Summanuss/openairqmonitor/docs/images/pcb_front_2.0.png

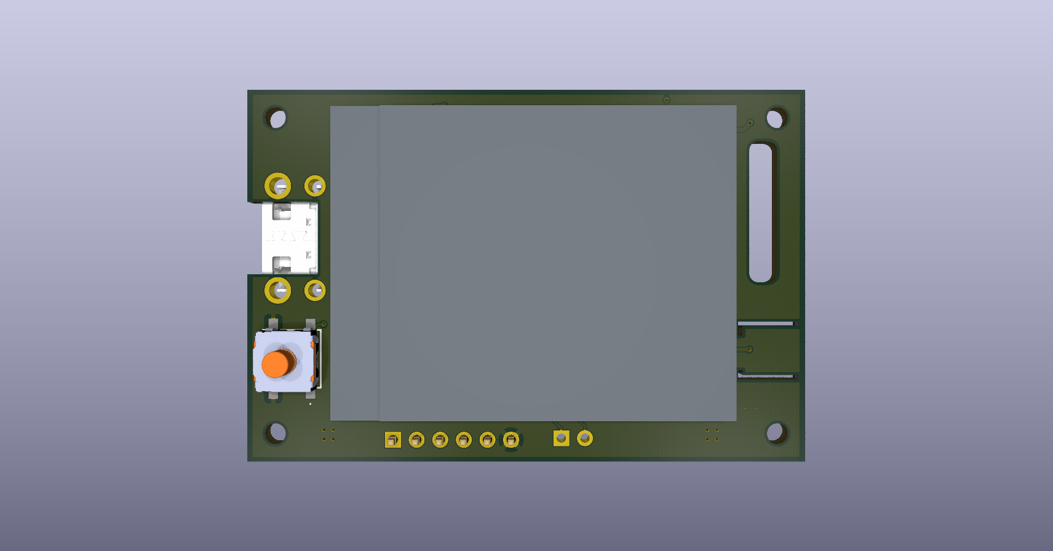
docs/images/pcb_front_2.0.png
