Summanuss/openairqmonitor/docs/images/pcb_layout_back_0.1.png

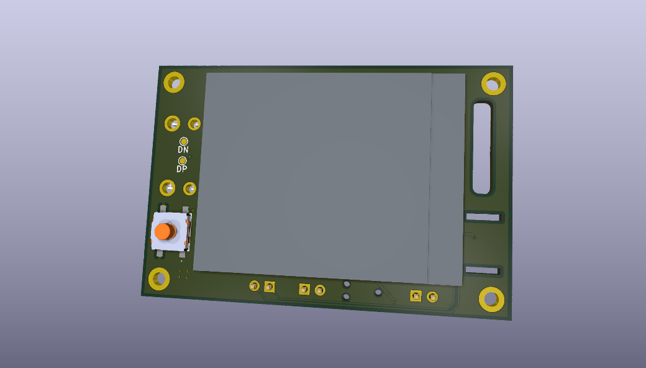
docs/images/pcb_layout_back_0.1.png
