Summanuss/openairqmonitor/docs/images/pcb_layout_front_0.1.png

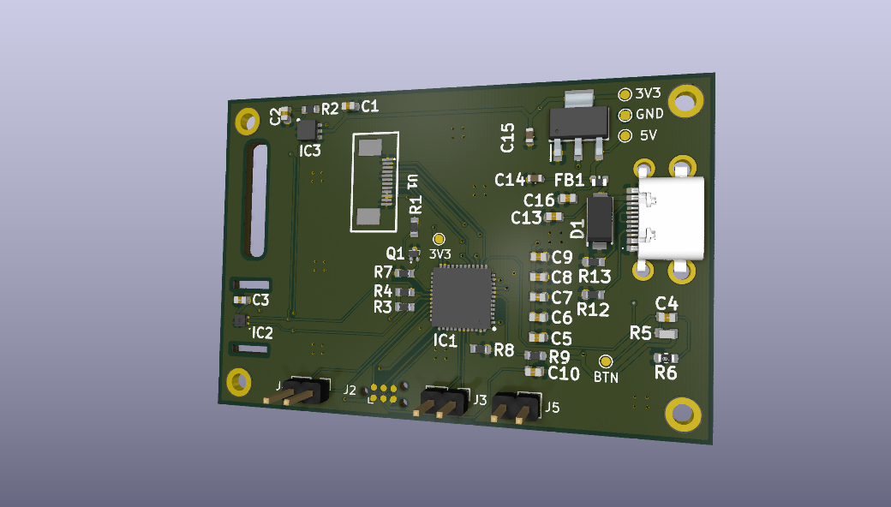
docs/images/pcb_layout_front_0.1.png
