Summanuss/openairqmonitor/exported/BOM_2.0.csv

Reference | Value | Datasheet | Footprint | Qty | DNP | Manufacturer_Name | Manufacturer_Part_Number | Mouser Part Number | Descrizione | MPN
C1,C2,C3,C4,C5,C17,C18,C19 | 100nF | https://datasheet.datasheetarchive.com/originals/distributors/Datasheets_SAMA/f8771fa45aebcb1f9cdf4689c164e498.pdf | amun_lib:CAPC1608X90N | 8 |  | Yageo Group | CC0603ZRY5V7BB104 | 603-CC603ZRY5V7BB104 | YAGEO - CC0603ZRY5V7BB104 - CERAMIC CAPACITOR, 0.1UF, 16V, Y5V, +80,-20%, 0603
C11,C12 | 1uF |  | amun_lib:CAPC1608X90N | 2 |  | SAMSUNG | CL10B105KP8NFNC | 187-CL10B105KP8NFNC | General Multilayer Ceramic Capacitors
C13,C16 | 2.2uF | https://datasheet.datasheetarchive.com/originals/distributors/Datasheets-DGA10/2411103.pdf | amun_lib:CAPC1608X90N | 2 |  | SAMSUNG | CL10A225KP8NNNC | 187-CL10A225KP8NNNC | Samsung Electro-Mechanics 0603 CL 2.2uF Ceramic Multilayer Capacitor, 10 V, +85C, X5R Dielectric, +/-10% SMD
C14 | 10uF | https://search.murata.co.jp/Ceramy/image/img/A01X/G101/ENG/GRM188R61A106ME69-01A.pdf | amun_lib:GRM18x | 1 |  | Murata Electronics | GRM188R61A106ME69J | 81-GRM188R61A106ME9J | MLCC, 0603 | GRM188R61A106ME69J
C15 | 22uF | https://search.murata.co.jp/Ceramy/image/img/A01X/G101/ENG/GRM187R61A226ME15-01A.pdf | amun_lib:GRM18x | 1 |  | Murata Electronics | GRM187R61A226ME15D | 81-GRM187R61A226ME5D | MLCC, 0603 | GRM187R61A226ME15D
D2 | SMAJ6.5CA_TR7 | https://www.mouser.it/datasheet/3/508/1/SMAJ_1.pdf | amun_lib:DIOM5127X250N | 1 |  | Yageo Group | SMAJ6.5CA/TR7 | 603-SMAJ6.5CA/TR7 | ESD Protection Diodes / TVS Diodes SMAJ - CA 6.5V
FB2 | BLM18PG330SH1D | http://www.murata.com/~/media/webrenewal/support/library/catalog/products/emc/emifil/c31e.ashx?la=en-gb | amun_lib:BLM18SP221SN1B | 1 |  | Murata Electronics | BLM18PG330SH1D | 81-BLM18PG330SH1D | Murata Power Solutions Ferrite Bead (Chip Bead), 1.6 x 0.8 x 0.8mm (1608), 33 impedance at 100 MHz
IC2 | SHT40-AD1B-R2 | https://www.digikey.com/en/products/detail/sensirion-ag/SHT40-AD1B-R2/13532084 | amun_lib:SHT40AD1BR2 | 1 |  | Sensirion | SHT40-AD1B-R2 | 403-SHT40-AD1B-R2 | 4th Generation, High-Accuracy, Ultra Low Power, 16-Bit Relative Humidity and Temperature Sensor Platform
IC3 | SGP40-D-R4 | https://www.mouser.it/datasheet/3/1278/1/Sensirion_Gas_Sensors_Datasheet_SGP40.pdf | amun_lib:SON80P244X244X95-7N | 1 |  | Sensirion | SGP40-D-R4 | 403-SGP40-D-R4 | Air Quality Sensors Gas Sensor 2.5k pcs IC | SGP40-D-R4
IC4 | AZ1117CH-3.3TRG1 | https://www.diodes.com//assets/Datasheets/AZ1117C.pdf | amun_lib:SOT230P700X180-4N | 1 |  | Diodes Incorporated | AZ1117CH-3.3TRG1 | 621-AZ1117CH-3.3TRG1 | 1.35A 3.3V LDO Reg. Current Limit SOT223 DiodesZetex AZ1117CH-3.3TRG1, LDO Voltage Regulator, 0.8A, 3.3 V +/-1%, maximum of 15 Vin, 3-Pin SOT-223
IC5 | STM32L431CCT6TR | https://www.st.com/resource/en/datasheet/stm32l431cb.pdf | amun_lib:QFP50P900X900X160-48N | 1 |  | STMicroelectronics | STM32L431CCT6TR | 511-STM32L431CCT6TR | Ultra-low-power Arm Cortex-M4 32-bit MCU+FPU, 100DMIPS, up to 256KB Flash, 64KB SRAM, analog, audio
J1 | UJ20-C-H-G-MSMT-4B-P16-TR | https://www.sameskydevices.com/product/resource/uj20-c-h-g-msmt-4b-p16-tr.pdf | amun_lib:UJ20CHGMSMT4BP16TR | 1 |  | Same Sky | UJ20-C-H-G-MSMT-4B-P16-TR |  | Type C, USB 2.0, 480 Mbps, 20 Vdc, 3 A, Horizontal, Mid Mount SMT, SMT Contacts, Gold Flash, 16 Pins, USB Receptacle | UJ20-C-H-G-MSMT-4B-P16-TR
J6 | SFV12R-1STBE1HLF | https://cdn.amphenol-cs.com/media/wysiwyg/files/drawing/sfv12b_hlf.pdf | amun_lib:SFV12R1STBE1HLF | 1 |  | Amphenol Communications Solutions | SFV12R-1STBE1HLF |  | 0.50mm Flex Connector, SFV-R Series, 12 Position, Bottom Side Contact, Side Entry Surface Mount ZIF Connector, Halogen Free, Lead Free, Gold Flash.
Q2 | SSM3K16FV,L3F | http://toshiba.semicon-storage.com/info/docget.jsp?did=591&prodName=SSM3K16FV | amun_lib:VESM_SOT-723_ | 1 |  | Toshiba | SSM3K16FV,L3F | 757-SSM3K16FVL3F | MOSFET LowON Res MOSFET ID=0.1A VDSS=20V
R1 | RC0603FR-134R7L | https://componentsearchengine.com/Datasheets/1/RC0603FR-134R7L.pdf | amun_lib:RESC1608X55N | 1 |  | Yageo Group | RC0603FR-134R7L | 603-RC0603FR-134R7L | Thick Film Resistors - SMD 4.7 OHM 1%
R2 | 4.7K | http://www.vishay.com/docs/20035/dcrcwe3.pdf | amun_lib:RESC1608X50N | 1 |  | Vishay | CRCW06034K70FKEC | 71-CRCW06034K70FKEC | Thick Film Resistors - SMD 4.7K OHM 1%
R5,R7,R9,R11,R14 | 10K | https://componentsearchengine.com/Datasheets/1/RT0603DRD0710KL.pdf | amun_lib:RESC1608X55N | 5 |  | Yageo Group | RT0603DRD0710KL | 603-RT0603DRD0710KL | Resistor,Thin Film Resistors - SMD 10K Ohm 0.5% 1/10W 75 Volts 25ppm
R6 | 10 | https://componentsearchengine.com/Datasheets/1/RC0603FR-7W10RL.pdf | amun_lib:RESC1608X55N | 1 |  | Yageo Group | RC0603FR-7W10RL | 603-RC0603FR-7W10RL | RESISTOR, 0603 10 Ohms +/-1% 1/10 W
R10 | 100 | https://componentsearchengine.com/Datasheets/1/RT0603FRE07100RL.pdf | amun_lib:RESC1608X60N | 1 |  | Yageo Group | RT0603FRE07100RL | 603-RT0603FRE07100RL | RESISTOR, 0603 100 Ohms +/-1% 1/10 W
R12,R13 | 5.1K | http://www.yageo.com/documents/recent/PYu-RC0603_51_RoHS_L_v5.pdf | amun_lib:RESC1608X55N | 2 |  | Yageo Group | RC0603FR-135K1L | 603-RC0603FR-135K1L | Thick Film Resistors - SMD 5.1K OHM 1%
S1 | EL2_52_35J_LFS | https://www.littelfuse.com/assetdocs/littelfuse-c-k-tactile-el2-series-datasheet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 | amun_lib:EL25235JLFS | 1 |  | LITTELFUSE | EL2 52 35J LFS | 611-EL25235JLFS | Tactile Switches 6.2x6.2x5.2mm 3.5N Operating Force -40C to 85C,150 mA | EL2 52 35J LFS
