Summanuss/openairqmonitor/exported/pcb_layout_2.0.step

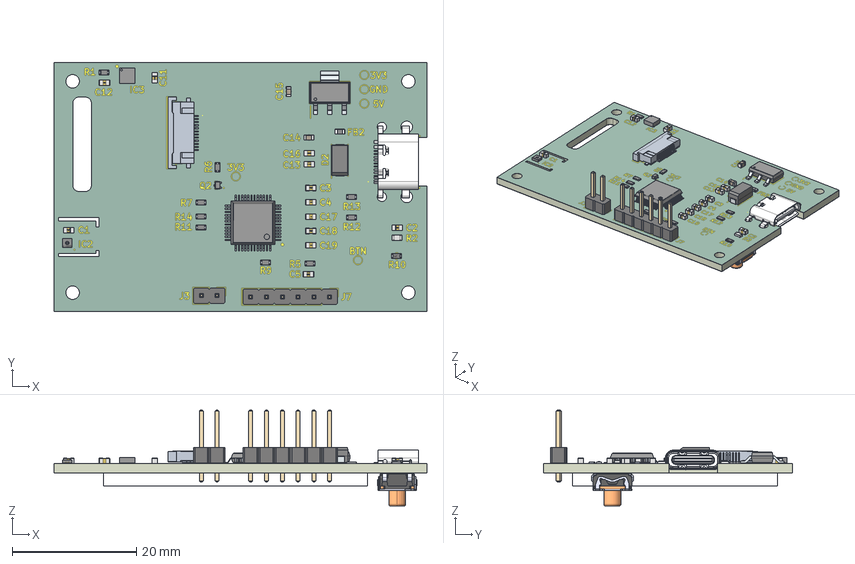
[picture p6: CAD file, 2026-10-18]
exported/pcb_layout_2.0.step
60.0 x 40.0 x 15.4 mm
CCS_CCSTDNOS_0603_L1.7W0.9T0.9B0.6 x 12
RC0603JR-07130RL x 9
PinHeader_1x06_P254mm_Vertical
PinsArrayLR x 2
PinsArrayTB
BLM18PG121SN1D
GRM188R72A471KA01J x 2
SHT40-AD1B-R2
PinsArrayL
FilletPinR
SSM3K16FV,L3F
Same_Sky_UJ20-C-H-G-MSMT-4B-P16-TR
RT0603FRE0727RL
ISFV12R_1STLF
FilletPin1
FilletPin2
ThermalPin
PinHeader_1x02_P254mm_Vertical
Display
Display_Support
EL2 52 35J LFS
AMUN_silkscreen x 2
AMUN_soldermask x 2
AMUN_PCB
