Summanuss/openairqmonitor/docs/schematics.pdf

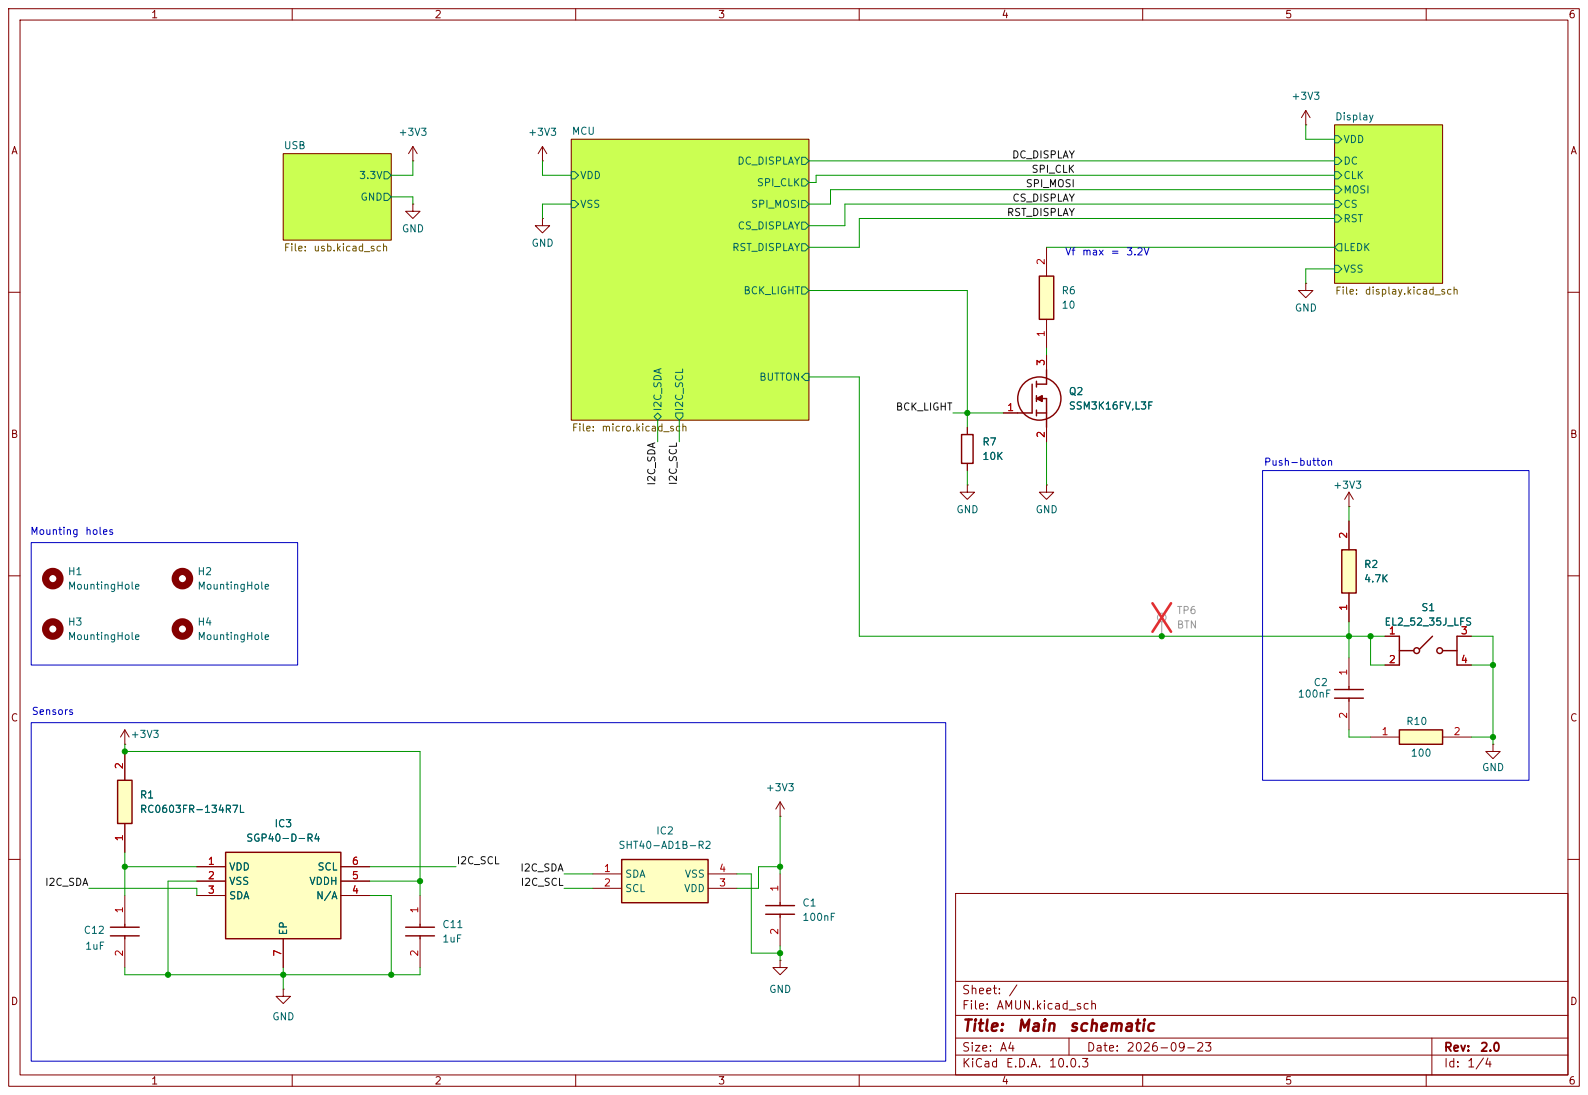
[picture p8: page 1]

Size: A4 | Rev: 2.0
KiCad E.D.A. 10.0.3 | Id: 1/4

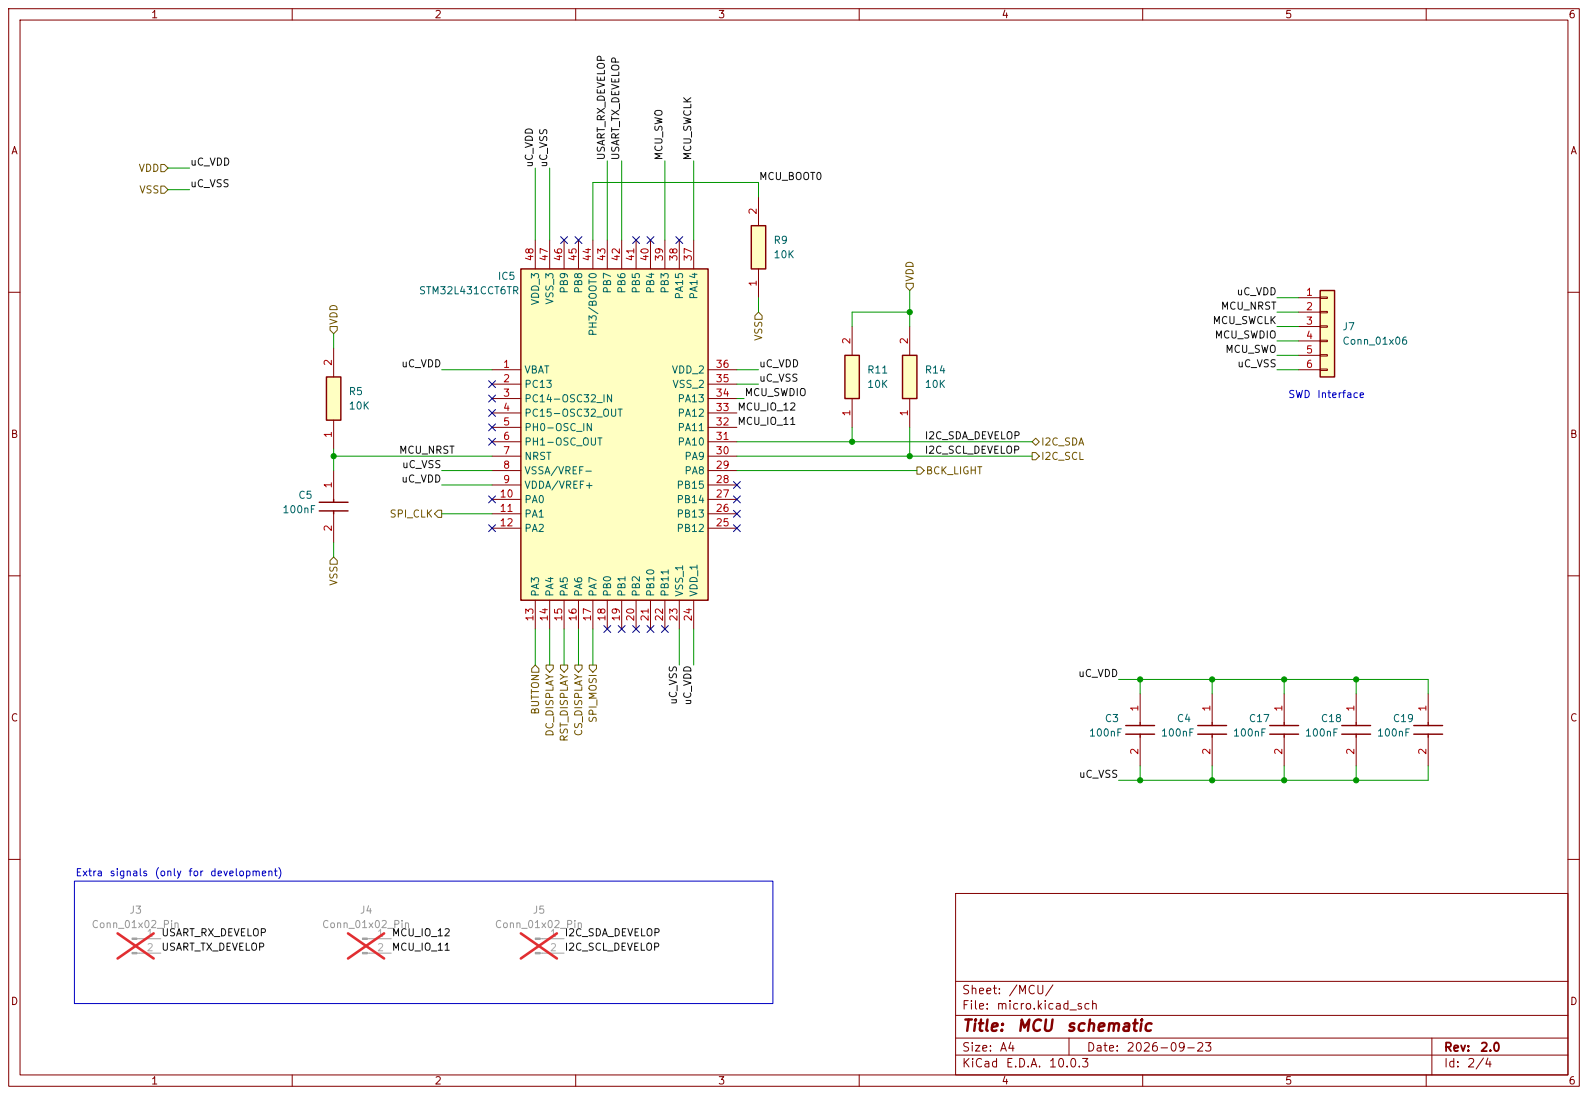
[picture p9: page 2]

Extra signals (only for development)

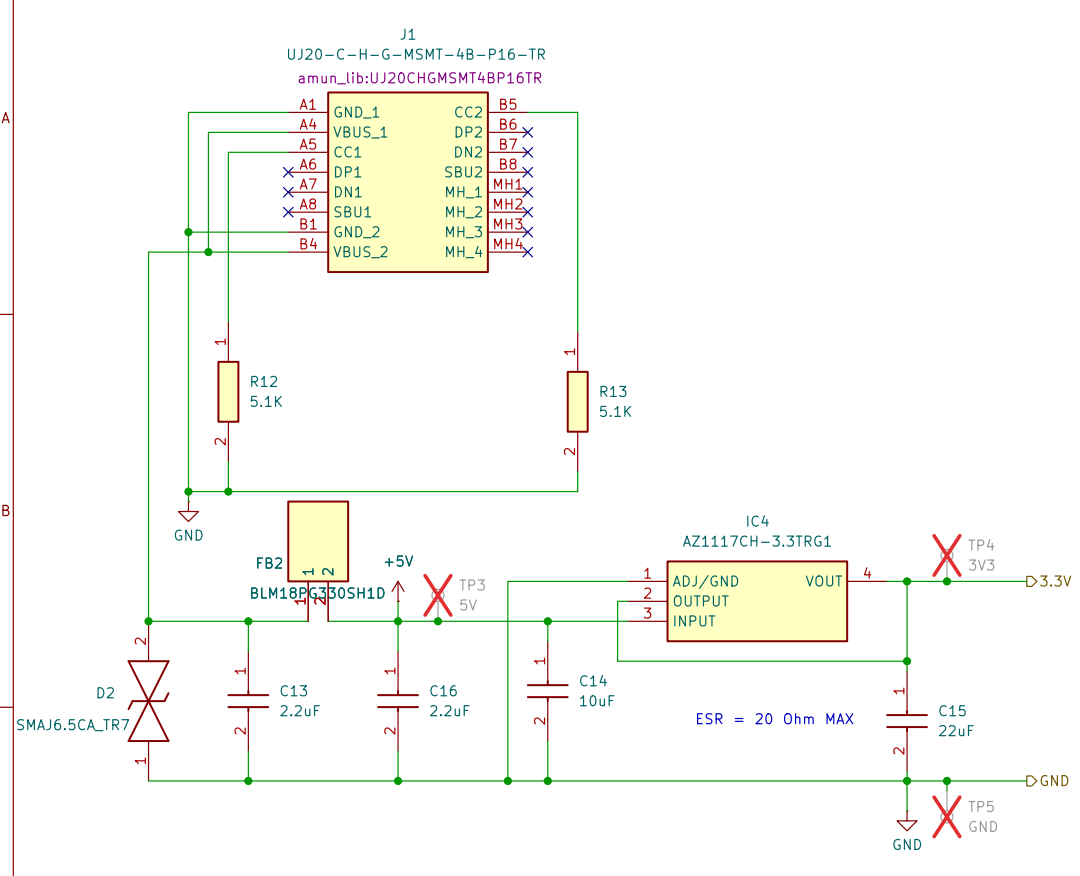
[picture p10: page 3]

Sheet: /USB/
File: usb.kicad_sch
Title: Power supply schematic

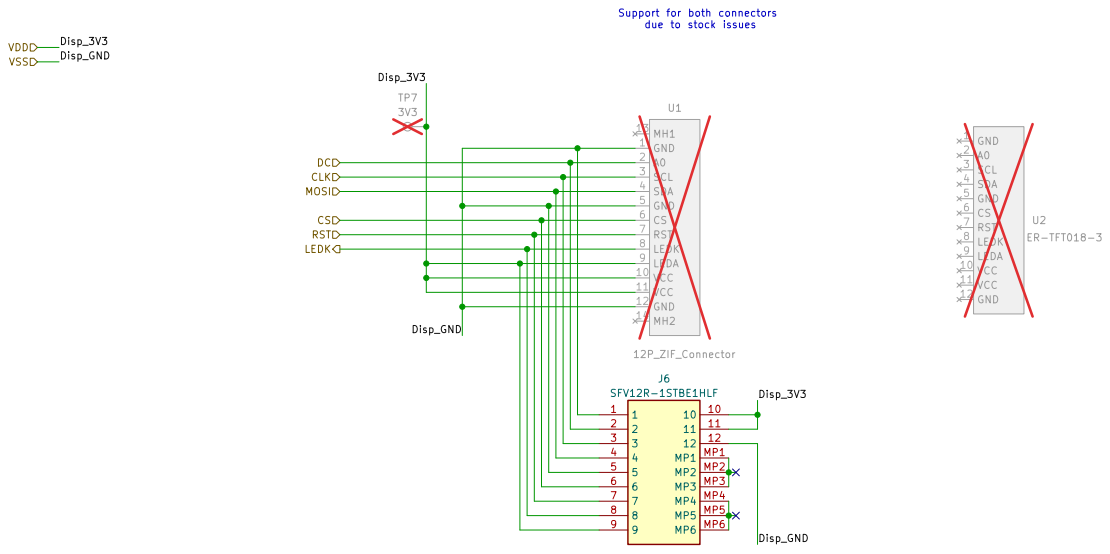
[picture p11: page 4]

Support for both connectors due to stock issues

LEDK 8 LEDA 9

VCC 10
