Summanuss/openairqmonitor/design/AMUN.kicad_pcb

## KiCad design design/AMUN.kicad_pcb (2026-10-18)

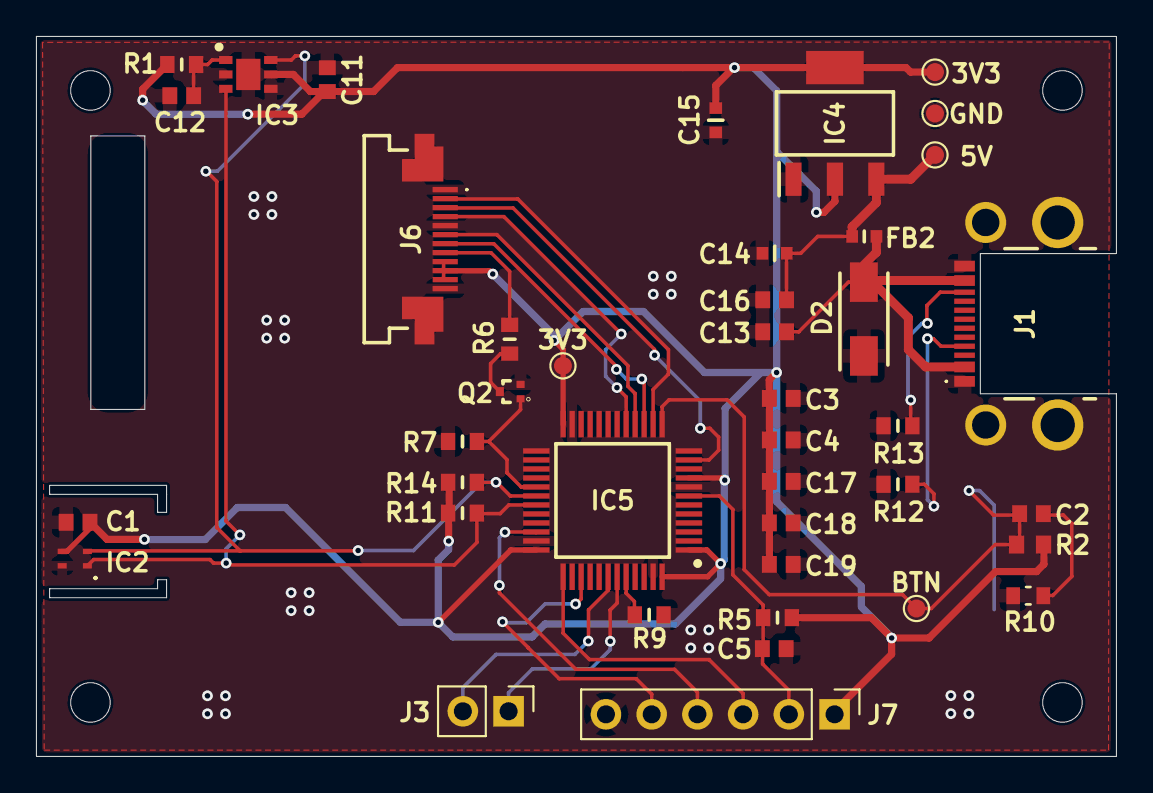
[picture p12: board AMUN.kicad_pcb from above]

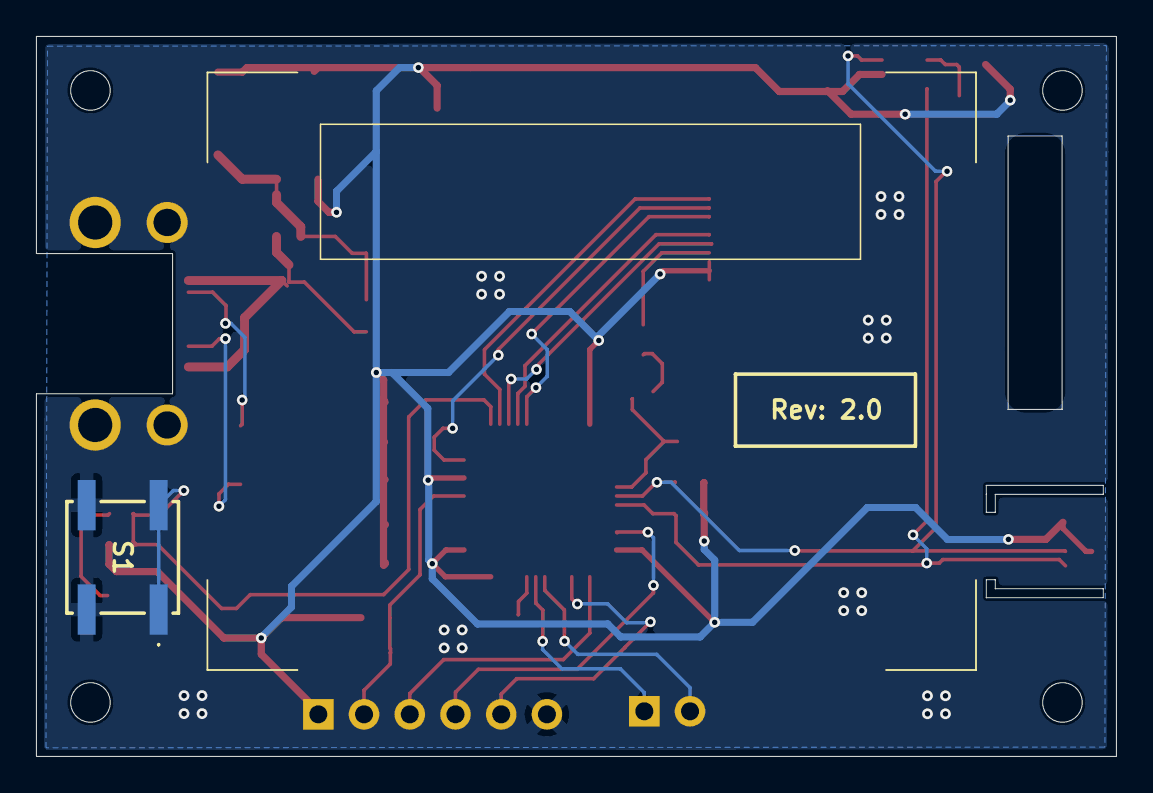
[picture p13: board AMUN.kicad_pcb from below]

Board: 2 copper layers, 60.0 x 40.0 mm, 47 parts (2 on the bottom side), 26 nets.

Parts:
3V3, 3V3#2: 3V3; TestPoint_Pad_D1.0mm
5V: 5V; TestPoint_Pad_D1.0mm
BTN: BTN; TestPoint_Pad_D1.0mm
C1, C2, C3, C4, C5, C17, C18, C19: 100nF; CAPC1608X90N
C11, C12: 1uF; CAPC1608X90N
C13, C16: 2.2uF; CAPC1608X90N
C14: 10uF; GRM18x
C15: 22uF; GRM18x
D2: SMAJ6.5CA_TR7; DIOM5127X250N
FB2: BLM18PG330SH1D; BLM18SP221SN1B
GND: GND; TestPoint_Pad_D1.0mm
H1, H2, H3, H4: MountingHole; MountingHole_2.2mm_M2_DIN965
IC2: SHT40-AD1B-R2; SHT40AD1BR2
IC3: SGP40-D-R4; SON80P244X244X95-7N
IC4: AZ1117CH-3.3TRG1; SOT230P700X180-4N
IC5: STM32L431CCT6TR; QFP50P900X900X160-48N
J1: UJ20-C-H-G-MSMT-4B-P16-TR; UJ20CHGMSMT4BP16TR
J3: Conn_01x02_Pin; PinHeader_1x02_P2.54mm_Vertical
J6: SFV12R-1STBE1HLF; SFV12R1STBE1HLF
J7: Conn_01x06; PinHeader_1x06_P2.54mm_Vertical
Q2: SSM3K16FV,L3F; VESM_SOT-723_
R1: RC0603FR-134R7L; RESC1608X55N
R2: 4.7K; RESC1608X50N
R5, R7, R9, R11, R14: 10K; RESC1608X55N
R6: 10; RESC1608X55N
R10: 100; RESC1608X60N
R12, R13: 5.1K; RESC1608X55N
S1: EL2_52_35J_LFS; EL25235JLFS
U2: ER-TFT018-3

Connections:
+3V3: 3V3.1 (1_1), 3V3#2.1 (1_1), C1.1, C3.1, C4.1, C11.1, C15.1, C17.1, C18.1, C19.1, IC2.3 (VDD), IC3.5 (VDDH), IC4.2 (OUTPUT), IC4.4 (VOUT), IC5.1 (VBAT), IC5.9 (VDDA/VREF+), IC5.24 (VDD_1), IC5.36 (VDD_2), IC5.48 (VDD_3), J6.9, J6.10, J6.11, J7.1, R1.2, R2.2, R5.2, R11.2, R14.2
+5V: 5V.1 (1_1), C14.1, C16.1, FB2.2, IC4.3 (INPUT)
/BCK_LIGHT: IC5.29 (PA8), Q2.1 (G), R7.1
/CS_DISPLAY: IC5.16 (PA6), J6.6
/DC_DISPLAY: IC5.14 (PA4), J6.2
/Display/LEDK: J6.8, R6.2
/I2C_SCL: IC2.2 (SCL), IC3.6 (SCL), IC5.30 (PA9), R14.1
/I2C_SDA: IC2.1 (SDA), IC3.3 (SDA), IC5.31 (PA10), R11.1
/MCU/BUTTON: BTN.1 (1_1), C2.1, IC5.13 (PA3), R2.1, S1.1 (COM_1), S1.2 (COM_2)
/MCU/MCU_BOOT0: IC5.44 (PH3/BOOT0), R9.2
/MCU/MCU_NRST: C5.1, IC5.7 (NRST), J7.2, R5.1
/MCU/MCU_SWCLK: IC5.37 (PA14), J7.3
/MCU/MCU_SWDIO: IC5.34 (PA13), J7.4
/MCU/MCU_SWO: IC5.39 (PB3), J7.5
/MCU/USART_RX_DEVELOP: IC5.43 (PB7), J3.1
/MCU/USART_TX_DEVELOP: IC5.42 (PB6), J3.2
/RST_DISPLAY: IC5.15 (PA5), J6.7
/SPI_CLK: IC5.11 (PA1), J6.3
/SPI_MOSI: IC5.17 (PA7), J6.4
GND: C1.2, C3.2, C4.2, C5.2, C11.2, C12.2, C13.2, C14.2, C15.2, C16.2, C17.2, C18.2, C19.2, D2.1, GND.1 (1_1), IC2.4 (VSS), IC3.2 (VSS), IC3.4 (N/A), IC3.7 (EP), IC4.1 (ADJ/GND), IC5.8 (VSSA/VREF-), IC5.23 (VSS_1), IC5.35 (VSS_2), IC5.47 (VSS_3), J1.A1 (GND_1), J1.B1 (GND_2), J6.1, J6.5, J6.12, J7.6, Q2.2 (S), R7.2, R9.1, R10.2 (R2), R12.2, R13.2, S1.3 (NO_1), S1.4 (NO_2)
unnamed: C12.1, IC3.1 (VDD), R1.1
unnamed: J1.A5 (CC1), R12.1
unnamed: J1.B5 (CC2), R13.1
unnamed: C13.1, D2.2, FB2.1, J1.A4 (VBUS_1), J1.B4 (VBUS_2)
unnamed: Q2.3 (D), R6.1
unnamed: C2.2, R10.1 (R1)
