Summanuss/openairqmonitor/(commit log)

2026-09-23 - Added design files; - Added doc files; - Added BOM file; - Added board STEP file; - Updated README.md.
    [AMUN.kicad_pcb, AMUN.kicad_sch, BOM_1.0.csv, micro.kicad_sch, pcb_layout_1.0.step, usb.kicad_sch]
2026-09-25 - Added display.kicad_sch; - Added mounting holes on schematic; - Removed TAG connect pads and used pin header; - Cut the PCB in order to make space for USB connector; - Changed mounting holes foorpr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
    [AMUN.kicad_pcb, AMUN.kicad_sch, micro.kicad_sch, usb.kicad_sch]
2026-09-27 Updated 3D models of components; Addend new PCB renders; Updated README.md; Updated board to revision 2.0; Schematic and layout cleanup and minor changes.
    [AMUN.kicad_pcb, AMUN.kicad_sch, micro.kicad_sch, usb.kicad_sch]
2026-10-18 - Added microcontroller datasheets; - Added fab files under fabrication/; - Moved display schematic in its own sheet; - Added pcb .step revision 2.0; - Added BOM 2.0; - Minor changes on README.md; - 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
    [AMUN-B_Cu.gbr, AMUN-B_Mask.gbr, AMUN-B_Paste.gbr, AMUN-B_Silkscreen.gbr, AMUN-Edge_Cuts.gbr, AMUN-F_Cu.gbr, AMUN-F_Mask.gbr, AMUN-F_Paste.gbr]
